DBXYD/Inverter_SQJQ910EL/Hardware/Inverter_MIC4605_SQJQ910EL_v2/Inverter_MIC4605_SQJQ910EL.kicad_pcb

## KiCad design Hardware/Inverter_MIC4605_SQJQ910EL_v2/Inverter_MIC4605_SQJQ910EL.kicad_pcb (2026-02-20)

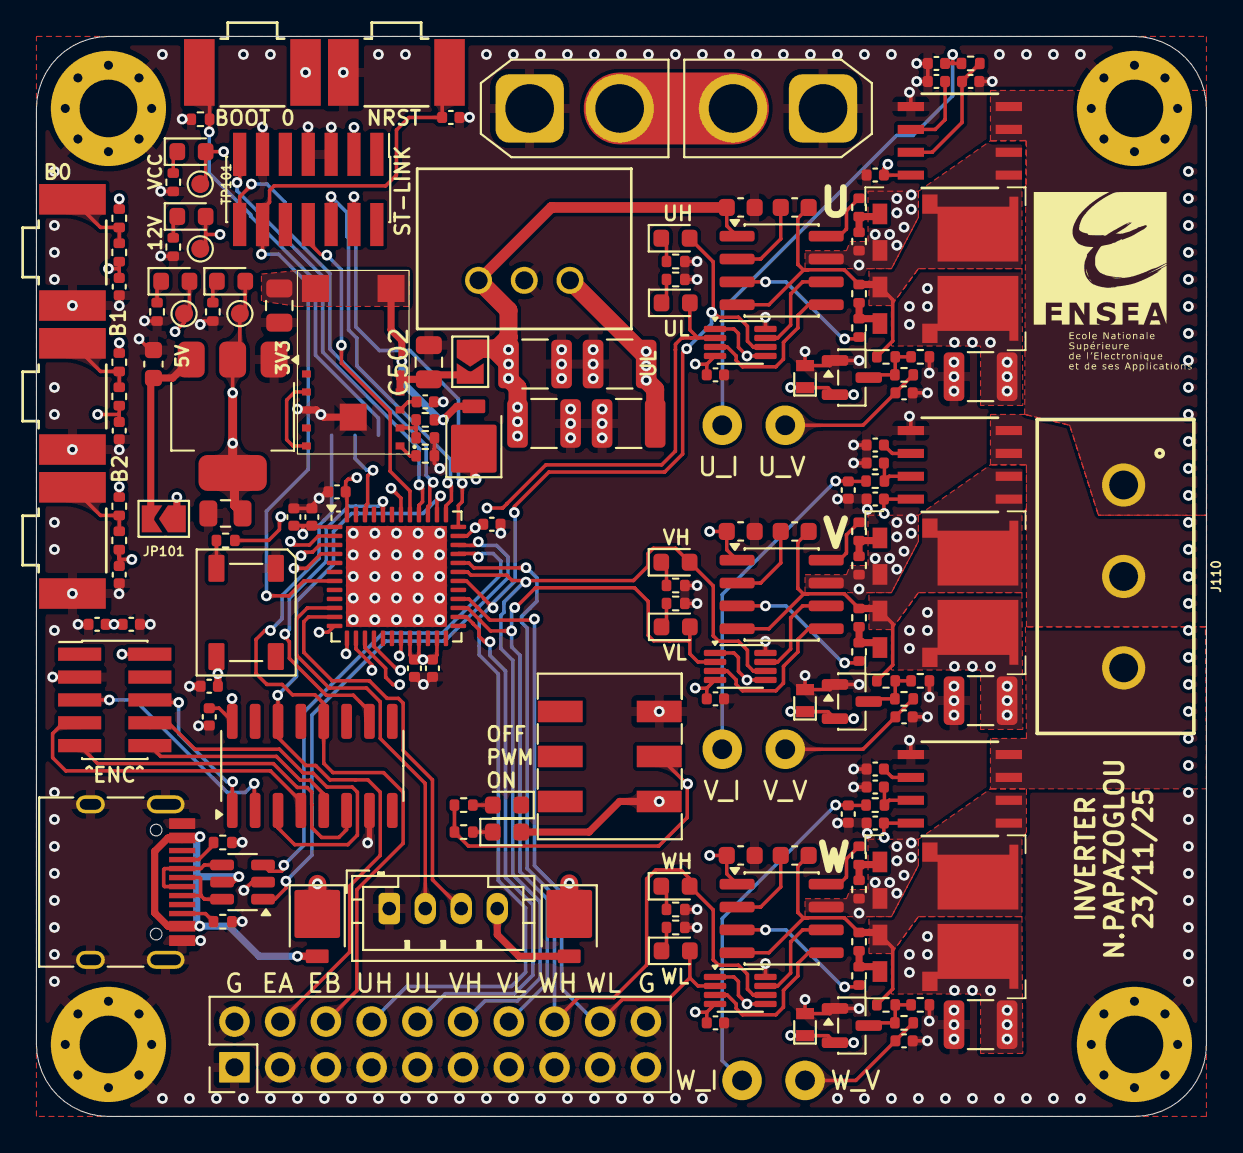
[picture p1: board Inverter_MIC4605_SQJQ910EL.kicad_pcb from above]

Board: 6 copper layers, 65.0 x 60.0 mm, 170 parts (1 on the bottom side), 108 nets.

Parts:
C101, C102, C103, C104, C105, C119, C139, C140, C142, C207, C209, C307, C309, C407, C409: 100n; C_0402_1005Metric
C106: 4u7; C_0402_1005Metric
C107, C110, C128, C204, C205, C206, C208, C304, C305, C306, C308, C404, C405, C406, C408: 10n; C_0402_1005Metric
C108: 10u; C_0603_1608Metric
C109: 22u; C_0805_2012Metric
C141, C504: 1u; C_0402_1005Metric
C201, C202, C301, C302, C401, C402: 1u; C_0603_1608Metric
C203, C303, C403, C701, C702: 10u; C_1210_3225Metric
C502: 10u; C_0805_2012Metric
C503: 47u; C_0805_2012Metric
C703, C704: 22u; C_1210_3225Metric
D101, D103, D104: SS2P5-M3/84A; D_SMP_DO-220AA
D102: WS2812B; LED_WS2812B_PLCC4_5.0x5.0mm_P3.2mm
D105, D106, D107, D108, D109, D110, D201, D202, D301, D302, D401, D402: LED; LED_0603_1608Metric
D203, D303, D403: 824032813; WE 824032813
D204, D304, D404: BAT54S; SOT-23
H101, H102, H105, H106: MountingHole_Pad; MountingHole_3.2mm_M3_Pad_Via
J101, J102: Conn_01x02; AMASS_XT30U-M_1x02_P5.0mm_Vertical
J104: PinHeader_2x07_P1.27mm_Vertical_SMD
J106: 629722000214; USB_C_Receptacle_HRO_TYPE-C-31-M-12
J107: Conn_02x05_Odd_Even; PinHeader_2x05_P1.27mm_Vertical_SMD
J108: Conn_01x04; JST_PH_B4B-PH-K_1x04_P2.00mm_Vertical
J109: Conn_02x10_Odd_Even; PinHeader_2x10_P2.54mm_Vertical
J110: Conn_01x03; WE 691311500103
JP101, JP501: SolderJumper_2_Open; SolderJumper-2_P1.3mm_Open_TrianglePad1.0x1.5mm
JP102: Jumper_3_Open; SolderJumper-3_P1.3mm_Open_RoundedPad1.0x1.5mm
R101, R102, R103, R104, R106, R107, R112, R202, R205, R209, R210, R302, R305, R309, R310, R402, R405, R409, R410: 10k; R_0402_1005Metric
R105: 330; R_0402_1005Metric
R108: 12k; R_0402_1005Metric
R109: 10k2; R_0402_1005Metric
R110: 3k2; R_0402_1005Metric
R111, R206, R207, R306, R307, R406, R407: 1k5; R_0402_1005Metric
R113, R114: 1k1; R_0402_1005Metric
R115, R116: 5k1; R_0402_1005Metric
R201, R204, R301, R304, R401, R404: 33; R_0402_1005Metric
R203, R303, R403: 1k; R_0402_1005Metric
R208, R308, R408: 180k; R_0402_1005Metric
R501: 402k; R_0402_1005Metric
R502: 80k6; R_0402_1005Metric
R503: 5k6; R_0402_1005Metric
SW101, SW102, SW103, SW104, SW105: SW_Push; KSS221GLFS
SW106: SW_Slide_DPDT; WE 452406020024
TP101, TP102: 24V; TestPoint_Pad_D1.0mm
TP103: 5V; TestPoint_Pad_D1.0mm
TP104: 3V3; TestPoint_Pad_D1.0mm
TP105, TP106, TP107, TP108, TP109, TP110: Pin_D1.1mm_L8.5mm_W2.5mm_FlatFork
U101: AZ1117-3.3; SOT-223
U102: STM32G431CBUx; QFN-48-1EP_7x7mm_P0.5mm_EP5.6x5.6mm
U103: USBLC6-2SC6; SOT-23-6
U104: MAX3097ECSE+; SOIC-16_3.9x9.9mm_P1.27mm
U201, U301, U401: SQJQ910EL
U202, U302, U402: SN74LVC2G08; VSSOP-8_2.3x2mm_P0.5mm
U203, U303, U403: MIC4605-1YM; SOIC-8_3.9x4.9mm_P1.27mm
U204, U304, U404: GO 10-SME/SP3; SOIC8-GO-SME&slash_SP3_LEM
U501: WE 171013801
U701: WE 173951275

Connections:
+3.3V: C101.1, C102.1, C103.2, C104.1, C105.1, C106.1, C109.1, C140.2, C204.1, C207.1, C304.1, C307.1, C404.1, C407.1, D108.2 (A), D109.2 (A), D203.1 (A1), D204.2 (K), D303.1 (A1), D304.2 (K), D403.1 (A1), D404.2 (K), J104.3 (VCC), R101.2, R103.2, R106.2, SW104.1, SW106.1 (A), TP104.1, U101.2 (VO), U101.4 (VO), U102.1 (VBAT), U102.20 (VREF+), U102.21 (VDDA), U102.23 (VDD), U102.35 (VDD), U102.48 (VDD), U104.16 (VCC), U202.4 (GND), U204.8 (UC), U302.4 (GND), U304.8 (UC), U402.4 (GND), U404.8 (UC)
+5V: C119.2, C141.1, C142.2, D101.1 (K), D102.1 (VDD), D103.1 (K), D104.1 (K), D107.2 (A), J107.2, JP101.1 (A), TP103.1
+12V: C201.1, C301.1, C401.1, C703.1, C704.1, D106.2 (A), JP501.1 (A), TP102.1, U203.1 (Vdd), U303.1 (Vdd), U403.1 (Vdd), U701.3 (12V)
/5V_BUCK: C503.1, D101.2 (A), R501.1, U501.6 (VOUT), U501.7 (VOUT)
/5V_UART: D104.2 (A), J108.4
/5V_USB: D103.2 (A), J106.A4 (VBUS), J106.A9 (VBUS), J106.B4 (VBUS), J106.B9 (VBUS), U103.5 (VBUS)
/A: J107.6, U104.1 (A)
/B: J107.8, U104.3 (B)
/BOOT_0: JP102.1 (A), R112.2, SW104.2
/BTN_0: C107.1, R102.1, U102.2 (PC13)
/BTN_1: C110.1, R104.1, U102.3 (PC14)
/BTN_2: C128.1, R107.1, U102.4 (PC15)
/D+: J106.A6 (D+), J106.B6 (D+), U103.6 (I/O1)
/D-: J106.A7 (D-), J106.B7 (D-), U103.4 (I/O2)
/EXT_RX: J108.3, U102.11 (PA3)
/EXT_TX: J108.2, U102.10 (PA2)
/MIC4605_SQJQ910EL_U/BM: C202.2, R202.2, R208.2, U201.3 (S), U201.5 (D), U203.4 (HS), U204.1 (IP+), U204.2 (IP+)
/MIC4605_SQJQ910EL_U/CMD_H: R201.1, U203.3 (HO)
/MIC4605_SQJQ910EL_U/CMD_L: R204.1, U203.8 (LO)
/MIC4605_SQJQ910EL_U/HB: C202.1, U203.2 (HB)
/MIC4605_SQJQ910EL_U/Imes: C205.1, R203.1, U204.7 (UOUT)
/MIC4605_SQJQ910EL_U/Uref: C206.1, U204.6 (UREF)
/MIC4605_SQJQ910EL_V/BM: C302.2, R302.2, R308.2, U301.3 (S), U301.5 (D), U303.4 (HS), U304.1 (IP+), U304.2 (IP+)
/MIC4605_SQJQ910EL_V/CMD_H: R301.1, U303.3 (HO)
/MIC4605_SQJQ910EL_V/CMD_L: R304.1, U303.8 (LO)
/MIC4605_SQJQ910EL_V/HB: C302.1, U303.2 (HB)
/MIC4605_SQJQ910EL_V/Imes: C305.1, R303.1, U304.7 (UOUT)
/MIC4605_SQJQ910EL_V/Uref: C306.1, U304.6 (UREF)
/MIC4605_SQJQ910EL_W/BM: C402.2, R402.2, R408.2, U401.3 (S), U401.5 (D), U403.4 (HS), U404.1 (IP+), U404.2 (IP+)
/MIC4605_SQJQ910EL_W/CMD_H: R401.1, U403.3 (HO)
/MIC4605_SQJQ910EL_W/CMD_L: R404.1, U403.8 (LO)
/MIC4605_SQJQ910EL_W/HB: C402.1, U403.2 (HB)
/MIC4605_SQJQ910EL_W/Imes: C405.1, R403.1, U404.7 (UOUT)
/MIC4605_SQJQ910EL_W/Uref: C406.1, U404.6 (UREF)
/NEO_PWM: R105.1, U102.42 (PB4)
/NRST: C139.1, J104.12 (~RST), SW105.1, U102.7 (PG10)
/OUT_A: J109.4, U102.38 (PA15), U104.14 (OutA)
/OUT_B: J109.6, JP102.3 (B), U104.12 (OutB)
/OUT_Z: U102.44 (PB6), U104.10 (OutZ)
/PWM_EN: R113.2, R114.1, SW106.2 (B), U202.1, U202.5, U302.1, U302.5, U402.1, U402.5
/PWM_U_H: D201.2 (A), J109.8, U102.30 (PA8), U202.6
/PWM_U_L: D202.2 (A), J109.10, U102.26 (PB13), U202.2
/PWM_V_H: D301.2 (A), J109.12, U102.31 (PA9), U302.6
/PWM_V_L: D302.2 (A), J109.14, U102.27 (PB14), U302.2
/PWM_W_H: D401.2 (A), J109.16, U102.32 (PA10), U402.6
/PWM_W_L: D402.2 (A), J109.18, U102.28 (PB15), U402.2
/SWCLK: J104.6 (JCLK/SWCLK), U102.37 (PA14)
/SWDIO: J104.4 (JTMS/SWDIO), U102.36 (PA13)
/SWO: J104.8 (JTDO/SWO), U102.41 (PB3)
/USB_DN: U102.33 (PA11), U103.3 (I/O2)
/USB_DP: U102.34 (PA12), U103.1 (I/O1)
/U_I_Sense: C208.1, R203.2, TP106.1, U102.19 (PB2)
/U_OUT: J110.1, U204.3 (IP-), U204.4 (IP-)
/U_V_Sense: C209.1, R209.2, TP105.1, U102.16 (PC4)
/VCP_RX: J104.13 (VCP_RX), U102.40 (PC11)
/VCP_TX: J104.14 (VCP_TX), U102.39 (PC10)
/V_I_Sense: C308.1, R303.2, TP108.1, U102.15 (PA7)
/V_OUT: J110.2, U304.3 (IP-), U304.4 (IP-)
/V_V_Sense: C309.1, R309.2, TP107.1, U102.14 (PA6)
/W_I_Sense: C408.1, R403.2, TP110.1, U102.12 (PA4)
/W_OUT: J110.3, U404.3 (IP-), U404.4 (IP-)
/W_V_Sense: C409.1, R409.2, TP109.1, U102.13 (PA5)
/Z: J107.10, U104.5 (Z)
//A: J107.5, U104.2 (/A)
//B: J107.7, U104.4 (/B)
//Z: J107.9, U104.6 (/Z)
GND: C101.2, C102.2, C103.1, C104.2, C105.2, C106.2, C107.2, C108.2, C109.2, C110.2, C119.1, C128.2, C139.2, C140.1, C141.2, C142.1, C201.2, C203.2, C204.2, C205.2, C206.2, C207.2, C208.2, C209.2, C301.2, C303.2, C304.2, C305.2, C306.2, C307.2, C308.2, C309.2, C401.2, C403.2, C404.2, C405.2, C406.2, C407.2, C408.2, C409.2, C502.2, C503.2, C504.2, C701.2, C702.2, C703.2, C704.2, D102.3 (VSS), D110.1 (K), D203.2 (A2), D204.1 (A), D303.2 (A2), D304.1 (A), D403.2 (A2), D404.1 (A), H101.1, H102.1, H105.1, H106.1, J101.1, J102.1, J104.5 (GND), J104.7 (GND), J104.11 (GNDDetect), J106.A1 (GND), J106.A12 (GND), J106.B1 (GND), J106.B12 (GND), J106.S1 (SHIELD), J107.3, J108.1, J109.1, J109.2, J109.3, J109.5, J109.7, J109.9, J109.11, J109.13, J109.15, J109.17, J109.19, J109.20, R108.2, R109.2, R110.2, R111.2, R112.1, R115.1, R116.2, R205.2, R206.2, R207.2, R210.2, R305.2, R306.2, R307.2, R310.2, R405.2, R406.2, R407.2, R410.2, R502.2, R503.2, SW101.2, SW102.2, SW103.2, SW105.2, SW106.3 (C), U101.1 (GND), U102.49 (VSS), U103.2 (GND), U104.7 (GND), U201.2 (S), U202.8 (Vcc), U203.7 (Vss), U204.5 (GND), U301.2 (S), U302.8 (Vcc), U303.7 (Vss), U304.5 (GND), U401.2 (S), U402.8 (Vcc), U403.7 (Vss), U404.5 (GND), U501.10 (AGND), U501.13 (PGND), U701.2 (GND)
unnamed: D102.4 (DIN), R105.2
unnamed: D105.1 (K), R108.1
unnamed: D106.1 (K), R109.1
unnamed: D107.1 (K), R110.1
unnamed: D108.1 (K), R111.1
unnamed: D109.1 (K), R113.1
unnamed: D110.2 (A), R114.2
unnamed: D201.1 (K), R206.1
unnamed: D202.1 (K), R207.1
unnamed: D204.3 (common), R208.1, R209.1, R210.1
unnamed: D301.1 (K), R306.1
unnamed: D302.1 (K), R307.1
unnamed: D304.3 (common), R308.1, R309.1, R310.1
unnamed: D401.1 (K), R406.1
unnamed: D402.1 (K), R407.1
unnamed: D404.3 (common), R408.1, R409.1, R410.1
unnamed: J106.A5 (CC1), R115.2
unnamed: J106.B5 (CC2), R116.1
unnamed: C108.1, JP101.2 (B), U101.3 (VI)
unnamed: JP102.2 (C), U102.46 (PB8)
unnamed: R101.1, R102.2, SW101.1
unnamed: R103.1, R104.2, SW102.1
unnamed: R106.1, R107.2, SW103.1
unnamed: R204.2, R205.1, U201.1 (G)
unnamed: R201.2, R202.1, U201.4 (G)
unnamed: U202.3, U203.5 (HI)
unnamed: U202.7, U203.6 (LI)
unnamed: R304.2, R305.1, U301.1 (G)
unnamed: R301.2, R302.1, U301.4 (G)
unnamed: U302.3, U303.5 (HI)
unnamed: U302.7, U303.6 (LI)
unnamed: R404.2, R405.1, U401.1 (G)
unnamed: R401.2, R402.1, U401.4 (G)
unnamed: U402.3, U403.5 (HI)
unnamed: U402.7, U403.6 (LI)
unnamed: U501.9 (VIN_LINK), U501.12 (En)
unnamed: R501.2, R502.1, U501.2 (FB)
unnamed: R503.1, U501.1 (FSW)
unnamed: C504.1, U501.3 (Vcc)
VCC: C203.1, C303.1, C403.1, C701.1, C702.1, D105.2 (A), J101.2, J102.2, TP101.1, U201.6 (D), U301.6 (D), U401.6 (D), U701.1 (VIN)
VIN: C502.1, JP501.2 (B), U501.4 (VIN), U501.5 (VIN)
