DBXYD/Inverter_SQJQ910EL/Hardware/Inverter_Motor_Adapt/Inverter_Motor_Adapt.kicad_pcb

## KiCad design Hardware/Inverter_Motor_Adapt/Inverter_Motor_Adapt.kicad_pcb (2026-02-20)

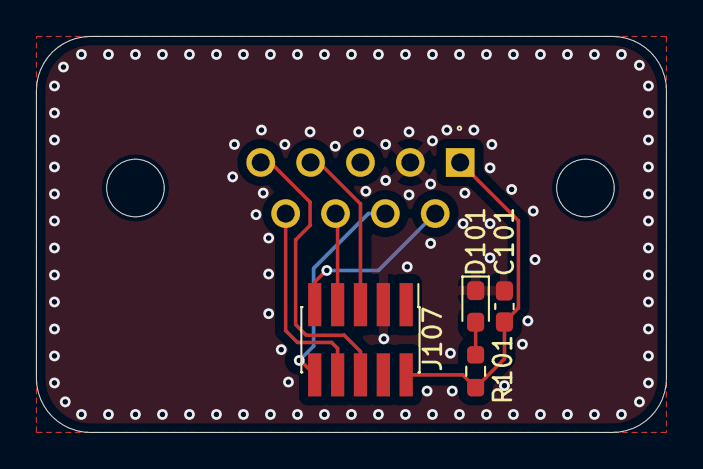
[picture p2: board Inverter_Motor_Adapt.kicad_pcb from above]

Board: 2 copper layers, 35.0 x 22.0 mm, 5 parts (1 on the bottom side), 9 nets.

Parts:
C101: 100n; C_0603_1608Metric_Pad1.08x0.95mm_HandSolder
D101: LED; LED_0603_1608Metric_Pad1.05x0.95mm_HandSolder
J101: DE9_Pins; DSUB-9_Pins_Vertical_P2.77x2.84mm
J107: Conn_02x05_Odd_Even; PinHeader_2x05_P1.27mm_Vertical_SMD
R101: 3k3; R_0603_1608Metric_Pad0.98x0.95mm_HandSolder

Connections:
+5V: C101.1, J101.1, J107.2, R101.1
/A: J101.5, J107.6
/B: J101.9, J107.8
/Z: J101.7, J107.10
//A: J101.4, J107.5
//B: J101.8, J107.7
//Z: J101.6, J107.9
GND: C101.2, D101.1 (K), J101.2, J107.3
unnamed: D101.2 (A), R101.2
