DBXYD/Inverter_SQJQ910EL/Firmware/inverter_firmware_v1/Inverter_STM32G431CBU6/Core/Src/main.c

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
/* Includes ------------------------------------------------------------------*/
#include "main.h"
#include "adc.h"
#include "dma.h"
#include "tim.h"
#include "usart.h"
#include "usb.h"
#include "gpio.h"

/* USER CODE BEGIN PTD */
#define PUTCHAR_PROTOTYPE int __io_putchar(int ch)
PUTCHAR_PROTOTYPE
{
	/* Place your implementation of fputc here */
	/* e.g. write a character to the USART1 and Loop until the end of transmission */
	HAL_UART_Transmit(&huart3, (uint8_t *)&ch, 1, 0xFFFF);

	return ch;
}
/* USER CODE END PTD */


/* USER CODE BEGIN PV */
uint8_t tick_10ms = 0;
/* USER CODE END PV */

void SystemClock_Config(void);
/**
 * @brief  The application entry point.
 * @retval int
 */
int main(void)
{

	/* MCU Configuration--------------------------------------------------------*/

	/* Reset of all peripherals, Initializes the Flash interface and the Systick. */
	HAL_Init();

	/* Configure the system clock */
	SystemClock_Config();

	/* Initialize all configured peripherals */
	MX_GPIO_Init();
	MX_DMA_Init();
	MX_ADC2_Init();
	MX_TIM1_Init();
	MX_TIM3_Init();
	MX_TIM8_Init();
	MX_USART2_UART_Init();
	MX_USART3_UART_Init();
	MX_USB_PCD_Init();
	MX_TIM4_Init();
	/* USER CODE BEGIN 2 */

	init_device();
	/* USER CODE END 2 */

	/* Infinite loop */
	/* USER CODE BEGIN WHILE */
	while (1)
	{
		if(tick_10ms){
			loop();
			tick_10ms = 0;
		}

		HAL_Delay(1);
		/* USER CODE END WHILE */

		/* USER CODE BEGIN 3 */
	}
	/* USER CODE END 3 */
}

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
/**
 * @brief  Period elapsed callback in non blocking mode
 * @note   This function is called  when TIM6 interrupt took place, inside
 * HAL_TIM_IRQHandler(). It makes a direct call to HAL_IncTick() to increment
 * a global variable "uwTick" used as application time base.
 * @param  htim : TIM handle
 * @retval None
 */
void HAL_TIM_PeriodElapsedCallback(TIM_HandleTypeDef *htim)
{
	/* USER CODE BEGIN Callback 0 */
	if (htim->Instance == TIM4){
		tick_10ms = 1;
	}
	/* USER CODE END Callback 0 */
	if (htim->Instance == TIM6)
	{
		HAL_IncTick();
	}
}

/**
 * @brief  This function is executed in case of error occurrence.
 * @retval None
 */
void Error_Handler(void)
{
	/* USER CODE BEGIN Error_Handler_Debug */
	/* User can add his own implementation to report the HAL error return state */
	__disable_irq();
	while (1)
	{
	}
	/* USER CODE END Error_Handler_Debug */
}
#ifdef USE_FULL_ASSERT
/**
 * @brief  Reports the name of the source file and the source line number
 *         where the assert_param error has occurred.
 * @param  file: pointer to the source file name
 * @param  line: assert_param error line source number
 * @retval None
 */
void assert_failed(uint8_t *file, uint32_t line)
{
	/* USER CODE BEGIN 6 */
	/* User can add his own implementation to report the file name and line number,
     ex: printf("Wrong parameters value: file %s on line %d\r\n", file, line) */
	/* USER CODE END 6 */
}
#endif /* USE_FULL_ASSERT */
