DBXYD/Inverter_SQJQ910EL/Firmware/inverter_firmware_v1/Inverter_STM32G431CBU6/Inverter_STM32G431CBU6.ioc

Mcu.UserName=STM32G431CBUx
PA10.GPIO_Label=PWM_W_H
PA10.Signal=S_TIM1_CH3
PA11.Signal=USB_DM
PA12.Signal=USB_DP
PA13.Signal=SYS_JTMS-SWDIO
PA14.Signal=SYS_JTCK-SWCLK
PA15.GPIO_Label=ENC_A
PA15.Signal=S_TIM8_CH1
PA2.GPIO_Label=EXT_TX
PA2.Signal=USART2_TX
PA3.GPIO_Label=EXT_RX
PA3.Signal=USART2_RX
PA4.GPIO_Label=W_I_Sense
PA4.Signal=ADC2_IN17
PA5.GPIO_Label=W_V_Sense
PA5.Signal=ADC2_IN13
PA6.GPIO_Label=V_V_Sense
PA6.Signal=ADC2_IN3
PA7.GPIO_Label=V_I_Sense
PA7.Signal=ADC2_IN4
PA8.GPIO_Label=PWM_U_H
PA8.Signal=S_TIM1_CH1
PA9.GPIO_Label=PWM_V_H
PA9.Signal=S_TIM1_CH2
PB13.GPIO_Label=PWM_U_L
PB13.Signal=TIM1_CH1N
PB14.GPIO_Label=PWM_V_L
PB14.Signal=TIM1_CH2N
PB15.GPIO_Label=PWM_W_L
PB15.Signal=TIM1_CH3N
PB2.GPIO_Label=U_I_Sense
PB2.Signal=ADC2_IN12
PB3.Signal=SYS_JTDO-SWO
PB4.GPIO_Label=PWM_NEO
PB4.Signal=S_TIM3_CH1
PB6.GPIO_Label=ENC_Z
PB6.Signal=S_TIM8_ETR
PB8-BOOT0.GPIO_Label=ENC_B
PB8-BOOT0.Signal=S_TIM8_CH2
PC10.GPIO_Label=VCP_TX
PC10.Signal=USART3_TX
PC11.GPIO_Label=VCP_RX
PC11.Signal=USART3_RX
PC13.GPIO_Label=BTN_0
PC13.Signal=GPXTI13
PC14-OSC32_IN.GPIO_Label=BTN_1
PC14-OSC32_IN.Signal=GPXTI14
PC15-OSC32_OUT.GPIO_Label=BTN_2
PC15-OSC32_OUT.Signal=GPXTI15
PC4.GPIO_Label=U_V_Sense
PC4.Signal=ADC2_IN5
