DBXYD/Inverter_SQJQ910EL/(commit log)

2026-02-20 add base hardware and firmware
    [171013801_submodule.kicad_sch, 173950575_submodule.kicad_sch, 173951275_submodule.kicad_sch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]
2026-03-25 update firmware
    [Inverter_STM32G431CBU6 Debug.cfg]
2026-03-25 add motor/control/fsm
    [Inverter_STM32G431CBU6 Debug.cfg]
