DBXYD/Inverter_SQJQ910EL/(notices)

Notices in the files:
Firmware/inverter_firmware_v1/Inverter_STM32G431CBU6/Core/Inc/main.h:
Copyright (c) 2026 STMicroelectronics.
All rights reserved.
This software is licensed under terms that can be found in the LICENSE file
